LasDesu/C128-kbdadp/hw/c128kbd.kicad_pcb

## KiCad design hw/c128kbd.kicad_pcb (2024-09-27)

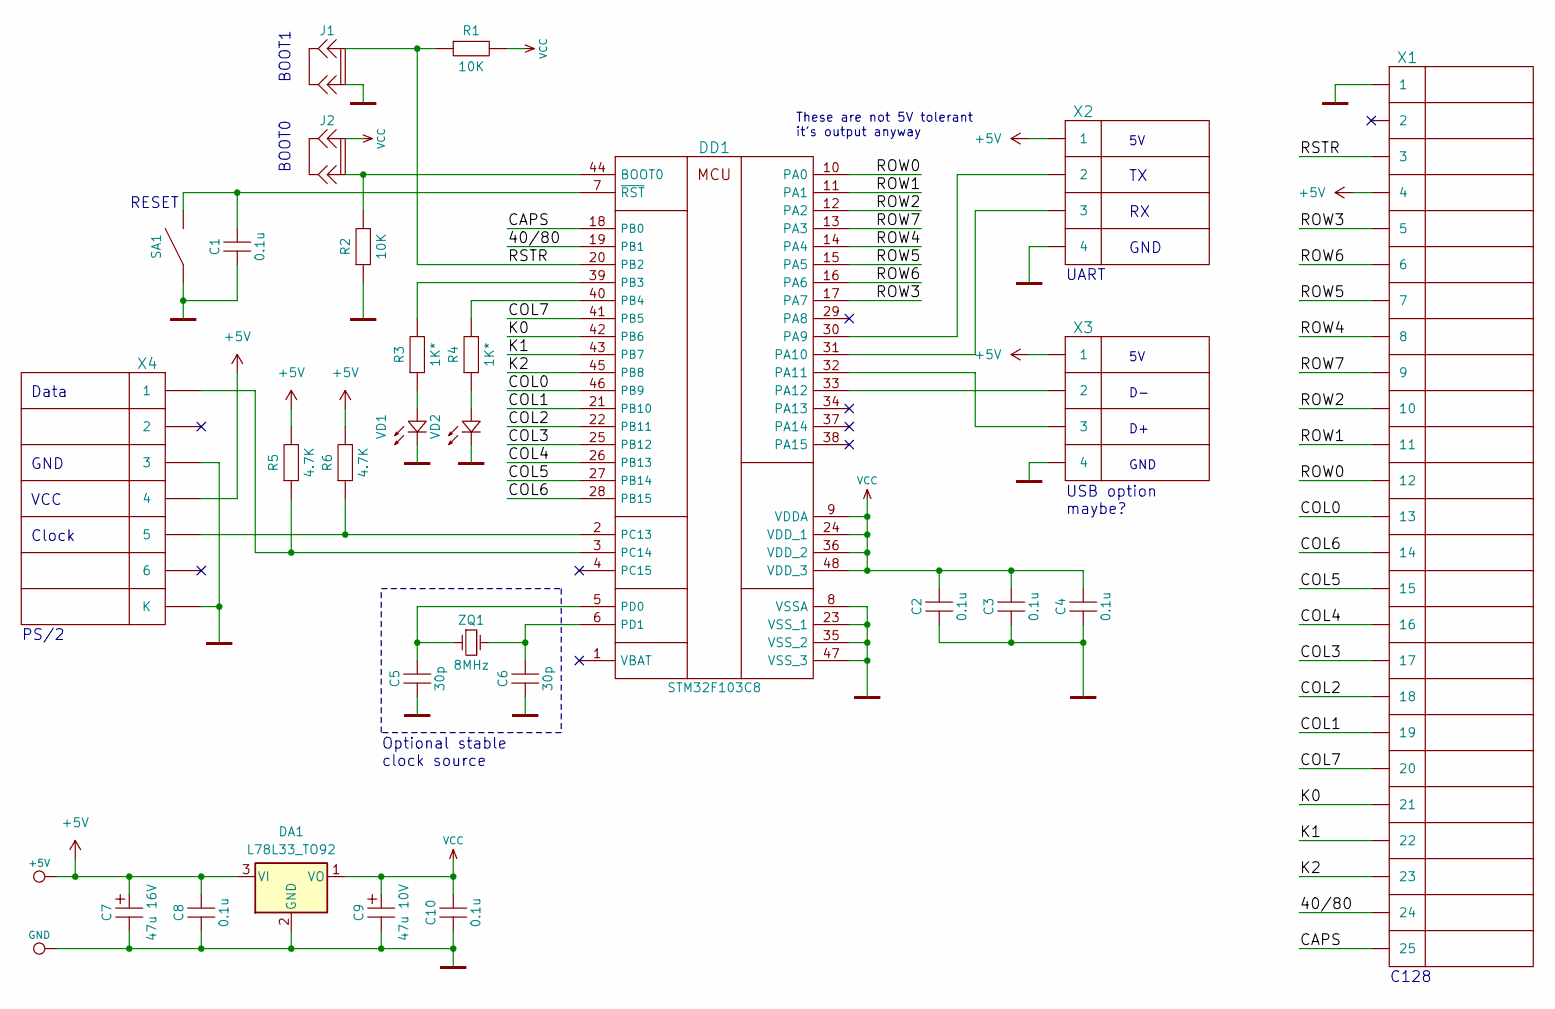
[picture p1: schematic c128kbd.kicad_sch, PS/2 to C128 keyboard adapter]

Parts:
C1, C2, C3, C4, C8, C10: 0.1u; C_0805_HandSoldering
C5, C6: 30p; C_0805_HandSoldering
C7: 47u 16V; CP_Radial_D5.0mm_P2.50mm
C9: 47u 10V; CP_Radial_D5.0mm_P2.50mm
DA1: L78L33_TO92; TO-92_Inline_Wide
DD1: STM32F103C8; LQFP-48_7x7mm_Pitch0.5mm
J1, J2: JUMPER2; Pin_Header_Straight_1x02_Pitch2.54mm
P1: +5V; Pin_Header_Straight_1x01_Pitch2.54mm
P2: GND; Pin_Header_Straight_1x01_Pitch2.54mm
R1, R2: 10K; R_0805_HandSoldering
R3, R4: 1K*; R_0805_HandSoldering
R5, R6: 4.7K; R_0805_HandSoldering
SA1: SW_OFF; Pin_Header_Straight_1x02_Pitch2.54mm
VD1, VD2: LED; LED_D3.0mm
X1: CONN-25; DSUB-25_Male_Horizontal_Pitch2.77x2.84mm_EdgePinOffset4.94m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
X2, X3: CONN-4; Socket_Strip_Straight_1x04_Pitch2.54mm
X4: CONN-6S; Mini_din6
ZQ1: 8MHz; Crystal_HC18-U_Vertical

Connections:
+5V: C7.1, C8.2, DA1.3 (VI), P1.1, R5.2, R6.2, X1.4, X2.1, X3.1, X4.4
/40/80: DD1.19 (PB1), X1.24
/CAPS: DD1.18 (PB0), X1.25
/COL0: DD1.46 (PB9), X1.13
/COL1: DD1.21 (PB10), X1.19
/COL2: DD1.22 (PB11), X1.18
/COL3: DD1.25 (PB12), X1.17
/COL4: DD1.26 (PB13), X1.16
/COL5: DD1.27 (PB14), X1.15
/COL6: DD1.28 (PB15), X1.14
/COL7: DD1.41 (PB5), X1.20
/K0: DD1.42 (PB6), X1.21
/K1: DD1.43 (PB7), X1.22
/K2: DD1.45 (PB8), X1.23
/ROW0: DD1.10 (PA0), X1.12
/ROW1: DD1.11 (PA1), X1.11
/ROW2: DD1.12 (PA2), X1.10
/ROW3: DD1.17 (PA7), X1.5
/ROW4: DD1.14 (PA4), X1.8
/ROW5: DD1.15 (PA5), X1.7
/ROW6: DD1.16 (PA6), X1.6
/ROW7: DD1.13 (PA3), X1.9
/RSTR: DD1.20 (PB2), J1.1, R1.1, X1.3
GND: C1.1, C2.1, C3.1, C4.1, C5.1, C6.1, C7.2, C8.1, C9.2, C10.1, DA1.2 (GND), DD1.8 (VSSA), DD1.23 (VSS_1), DD1.35 (VSS_2), DD1.47 (VSS_3), J1.2, P2.1, R2.1, SA1.1, VD1.1, VD2.1, X1.1, X2.4, X3.4, X4.3, X4.S (К)
unnamed: DD1.44 (BOOT0), J2.2, R2.2
unnamed: DD1.30 (PA9), X2.2
unnamed: DD1.31 (PA10), X2.3
unnamed: DD1.32 (PA11), X3.3
unnamed: DD1.33 (PA12), X3.2
unnamed: DD1.39 (PB3), R3.2
unnamed: DD1.40 (PB4), R4.2
unnamed: DD1.2 (PC13), R6.1, X4.5
unnamed: DD1.3 (PC14), R5.1, X4.1
unnamed: C5.2, DD1.5 (PD0), ZQ1.1
unnamed: C6.2, DD1.6 (PD1), ZQ1.2
unnamed: C1.2, DD1.7 (~RST), SA1.2
unnamed: R3.1, VD1.2
unnamed: R4.1, VD2.2
VCC: C2.2, C3.2, C4.2, C9.1, C10.2, DA1.1 (VO), DD1.9 (VDDA), DD1.24 (VDD_1), DD1.36 (VDD_2), DD1.48 (VDD_3), J2.1, R1.2

Notes on the sheet:
PS/2
VCC
BOOT0
UART
GND
C128
Clock
Optional stable clock source
BOOT1
These are not 5V tolerant it's output anyway
RESET
Data
USB option maybe?

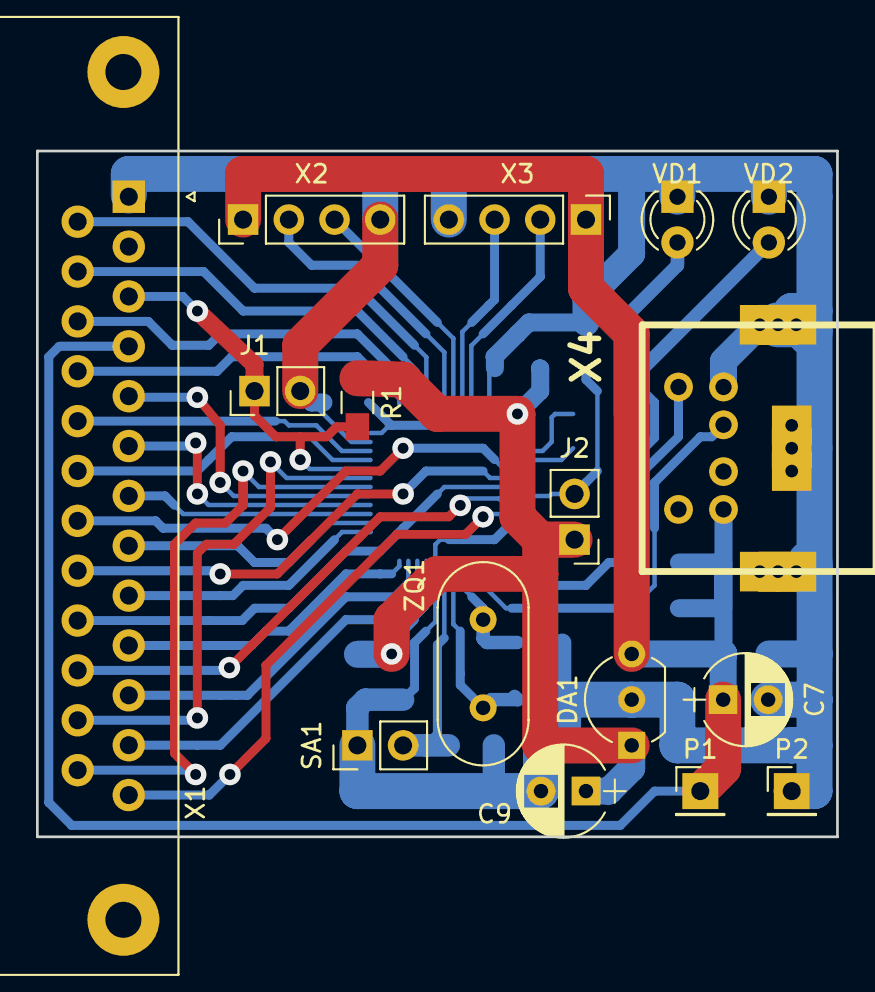
[picture p2: board c128kbd.kicad_pcb from above]

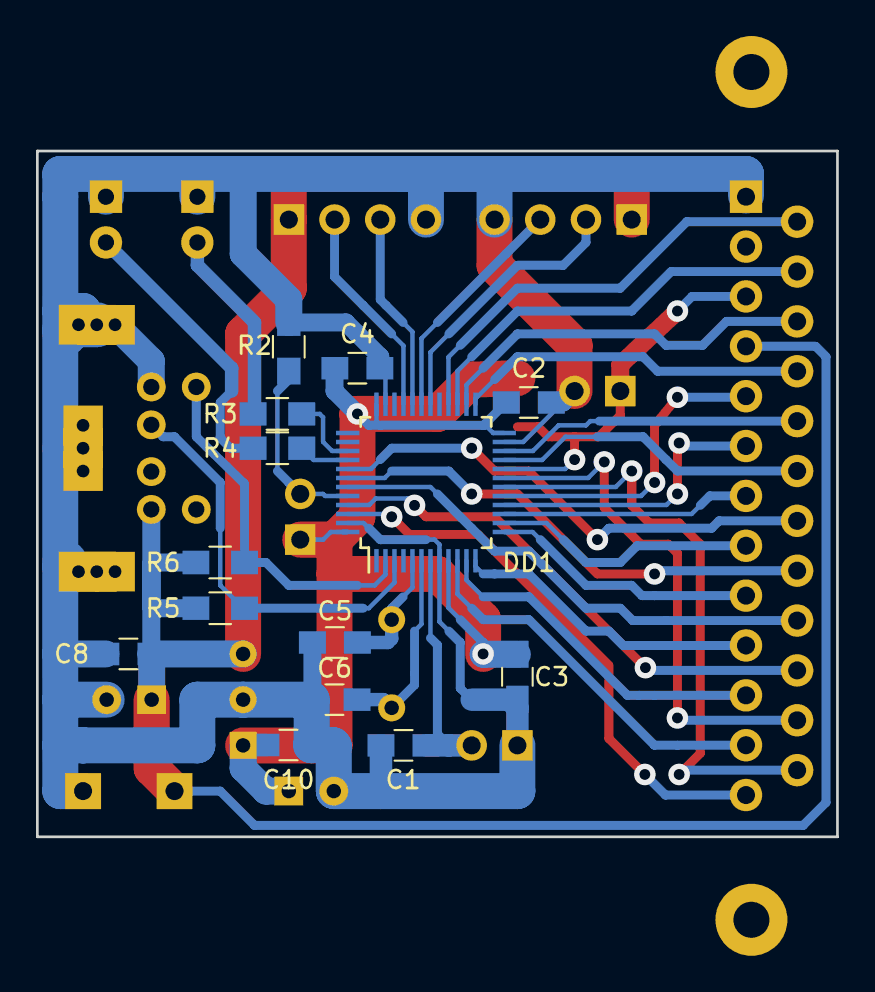
[picture p3: board c128kbd.kicad_pcb from below]

Board: 2 copper layers, 44.5 x 38.1 mm, 30 parts (14 on the bottom side), 39 nets.
