LasDesu/C128-kbdadp/(commit log)

2018-07-08 Add firmware
    [c128kbd Release.cfg]
2019-08-25 Unfinished new PCB and gerbers used to produce first experimental version
    [c128kbd.kicad_pcb, c128kbd.sch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]
2020-05-31 Fix cursor keys; add C64 cursor key emulation (Num-lock switched, enabled by default)
    [c128keys.h, kbd_iface.h, kbd_layout.c, ps2kbd.c, ps2scans.h]
2020-05-31 More or less final version of hardware
    [c128kbd.kicad_pcb, c128kbd.sch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]
2020-05-31 Cosmetic fixes
    [c128kbd.kicad_pcb]
2024-09-27 hw: update to kicad 8, should be no problems with cache
    [c128kbd.kicad_pcb, c128kbd.kicad_sch, c128kbd.sch]
